frkatona/teensy-ekit-module/images/oscilloscope_kick_total.png

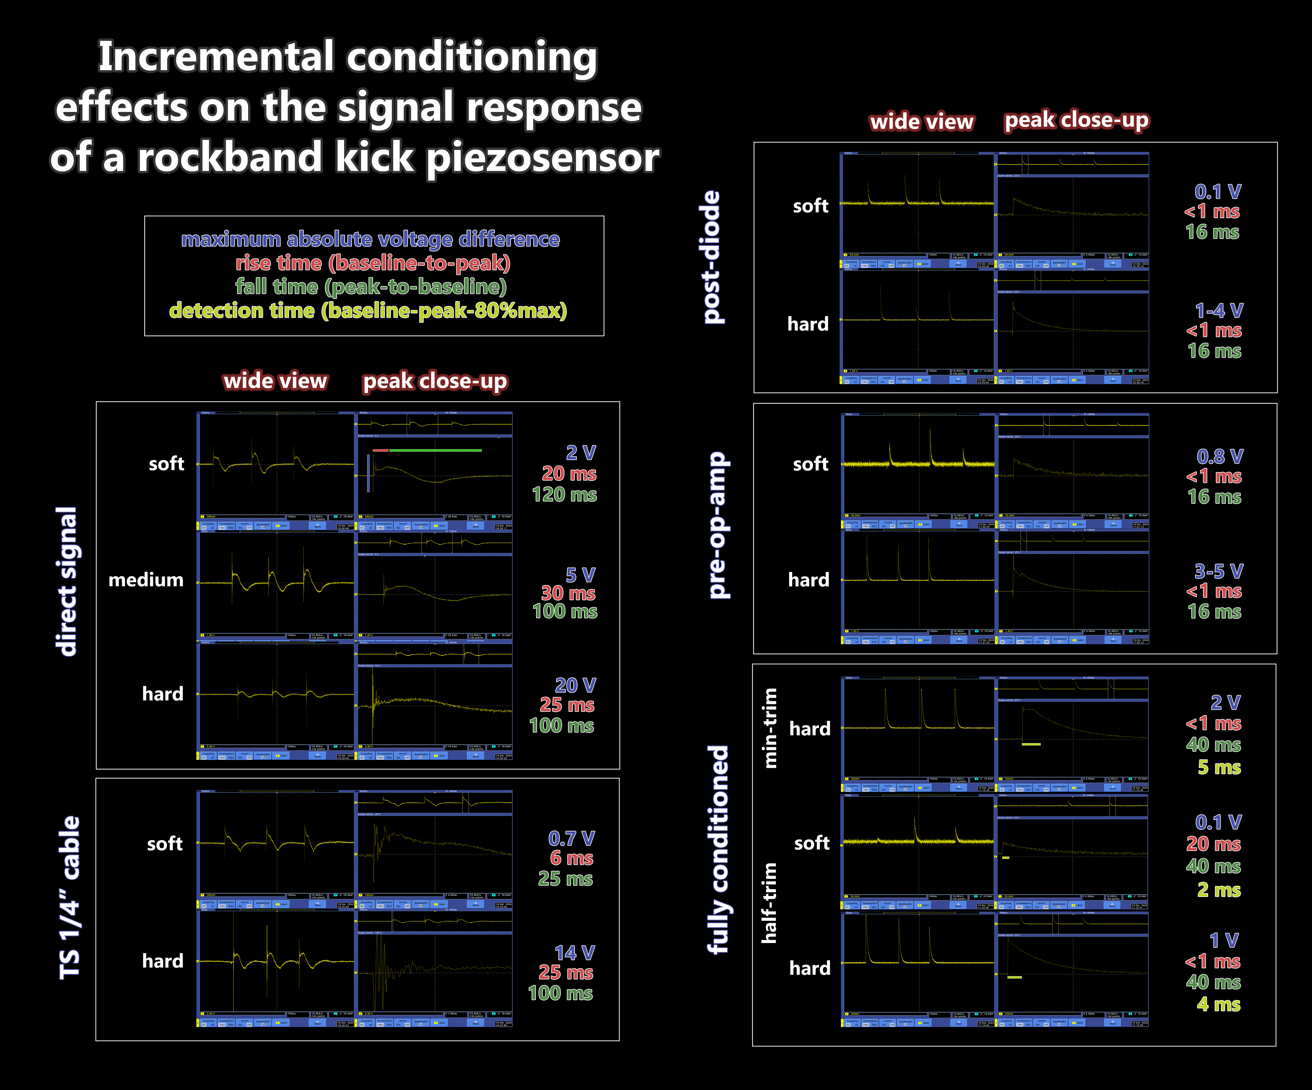
images/oscilloscope_kick_total.png
