frkatona/teensy-ekit-module/images/teensy4-1.jpeg

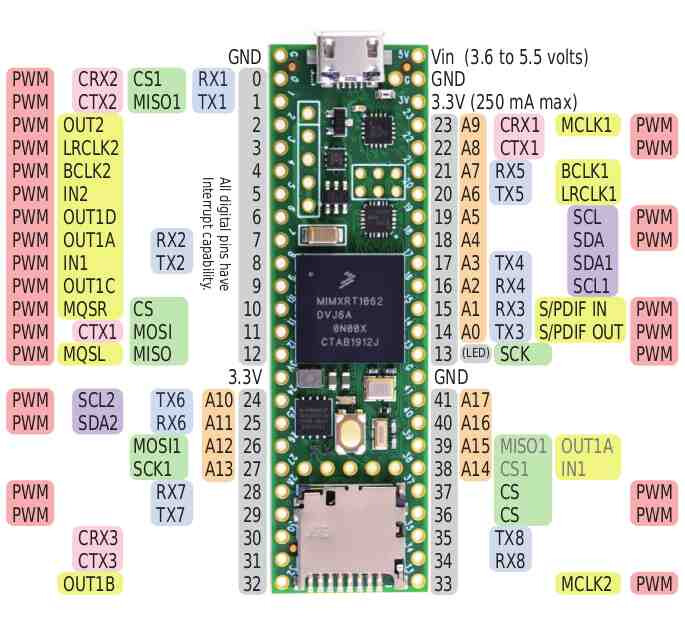
images/teensy4-1.jpeg
