frkatona/teensy-ekit-module/(list of files, cad)

Other CAD files:
ekitHousing_3DP.blend
