frkatona/teensy-ekit-module/(commit log)

2024-08-12 added CC controlling (hasn't broken notes but haven't tested hat control yet)
    [EKitModule.ino]
2024-12-20 updated readme and added blend file
    [ekitHousing_3DP.blend]
